Flemmbrav/VideoASIC/README.md

VideoASIC
=========

CCD video digitizer developed with gEDA, ngspice, and openIP
