Flemmbrav/VideoASIC/Source/README

This directory is for the schematics, symbols, and subcircuit models of the ASIC
circuitry.
