Flemmbrav/VideoASIC/(commit log)

2012-08-08 Import symbols. Begin switch design.
    [DPST-NC.sch]
2012-08-08 Add SPICE subcircuit stuff to DPST-NC
    [DPST-NC.sch]
2012-08-10 Fix openIP symbols and library to have non-global power.
2012-08-12 First simulation: switch on-resitance
    [DPST-NC.sch, on-resistance-test.sch]
2012-08-13 Simulating switch on-resistance and break-before-make using level 3 models
    [DPST-NC.sch, SimPwr.sch, on-resistance-test.sch]
2012-10-01 Make modulator with delayless integrators.
    [V2Q.sch]
2012-10-26 Pump and V2Q
    [Pump.sch, V2Q.sch]
2012-10-28 Import filter components, begin filter drawing.
    [CMS.sch, InverterX.sch, Q2V.sch, twoStage.sch]
2012-10-30 Differential charge amp, more details on the two stage filter.
    [DiffQ2V.sch, twoStage.sch]
2012-11-03 Begin intensive simulations.
    [CMS.sch, InverterX.sch, InverterXac.sch, InverterXgm.sch, Pump.sch, V2Q.sch, twoStage.sch]
2012-11-03 More simulation prep.
    [CMS.sch, DPST-NC.sch, InverterXac.sch, Pump.sch, Q2V.sch, V2Q.sch, twoStage.sch]
2012-11-03 Only include necessary OpenIP circuits.
    [DiffQ2V.sch, InverterX.sch]
2012-11-04 Balance DPST using BSIM models. Moving to a single filter schem.
    [DPST-NC.sch, twoStage.sch]
2012-11-04 Go back to a V2Q with switchable polarity.
    [V2Q.sch]
2012-11-06 InverterX optimization. Comparator import and optimization. More modulator details.
    [Comparator.sch, ComparatorTest.sch, Igm.sch, InverterX.sch, Modulator.1.sch, Modulator.2.sch, Q2V.sch, twoStage.sch]
2012-11-19 More work on Modulator
    [Modulator.1.sch]
2012-11-28 First "complete" draft of modulator
    [G1.sch, G2.sch, Modulator.1.sch, Modulator.2.sch, Modulator.3.sch, V2Q.sch]
2012-11-28 Can now build modulator netlist.
    [Modulator.2.sch]
2012-11-28 Improve "make clean" Missed OpenIP Opamp stuff
    [OP3_test.sch]
2012-12-02 First light on modulator sim.
    [G1.sch, G2.sch, ModulatorNoise.sch, UnBal.sch]
2012-12-02 Looking into reducing capacitances
    [InverterXac.sch, InverterXgm.sch]
2012-12-04 Fix zero length strings in OpenIP symbols. Optimize InverterX. Non-overlapping clock generator. Single-ended shaping filter.
    [ClockGen.sch, ClockGenTest.sch, Filter.sch, Integrator.sch, InverterX.sch, InverterXtran.sch, Modulator.sch, PolSim.sch]
2012-12-05 Fix dates/titles for PDR schematics
    [ClockGen.sch, Filter.sch, Q2V.sch, V2Q.sch]
2012-12-07 First changes from PDR: no g coefficients, round numbers for others.
    [Filter.sch, PolSim.sch, Polarity.sch, Q2V.sch]
2012-12-18 First draft of simplified modulator.
    [Modulator.sch, Polarity.sch]
2012-12-19 Working modulator
    [Filter.sch, Modulator.sch, ModulatorNoise.sch]
2012-12-19 Begin import of Preamp
    [DPST-NC.sch, Preamplifier-gain.sch, Preamplifier.sch, QOP.sch]
2012-12-20 First complete drawing of preamplifier
    [Preamplifier-gain.sch, Preamplifier.sch]
2013-01-02 DAC and its subcircuits
    [CRbit.sch, DACbit.sch, PumpDAC.sch]
2013-01-03 Import chain schems
    [Chain.1.sch, Chain.2.sch]
2013-01-03 Some fixes to Chain.1
    [Chain.1.sch]
2013-01-04 Finish importing Chain
    [Bias10uA.sch, Chain.1.sch, Chain.2.sch]
2013-01-06 Add sync subcircuit
    [Sync.sch]
2013-01-11 Make sure all symbols have device= Begin top level drawing.
    [TOP.1.sch, TOP.2.sch, TOP.3.sch, TOP.4.sch, TOP.5.sch]
2013-01-11 First "complete" draft.
    [DACbit.sch, LVRP.sch, SwitchableTerminator.sch, TOP.1.sch, TOP.2.sch, TOP.3.sch, TOP.4.sch, TOP.5.sch]
2013-01-12 Fix compatibility problems between pads and OpenIP Self-consistent library of subcircuits
    [TOP.1.sch, TOP.7.sch]
2013-01-14 Work around weirn ngspice bug (netname=n). Make printable schems. Preamp gain. PumpDAC gain. Sync fast digital inputs.
    [DPST-NC.sch, Preamplifier.sch, PumpDAC.sch, TOP.6.sch]
2013-01-14 Fix net name in gain circuit. Add stimulus code for chain test.
    [Preamplifier-gain.sch]
2013-01-15 Fix spice prototypes for LVDS interface blocks. Changes to comparators suggested by Ikeda-sensei. Sign changes to clamp and DAC enable.
    [Chain.1.sch, Comparator.sch, LVRP.sch, SwitchableTerminator.sch, TOP.2.sch, TOP.3.sch, TOP.4.sch, TOP.5.sch]
2013-02-05 Fix open circuit in PATH. Fix short circuit in Chain.
    [Chain.1.sch]
